eta4ever/rapid-rework/photo/smd.jpg

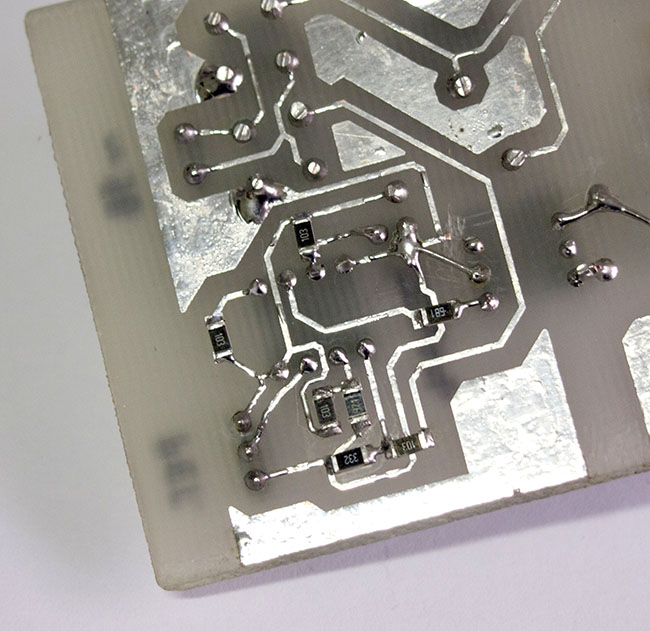
photo/smd.jpg
