eta4ever/rapid-rework/photo/board.jpg

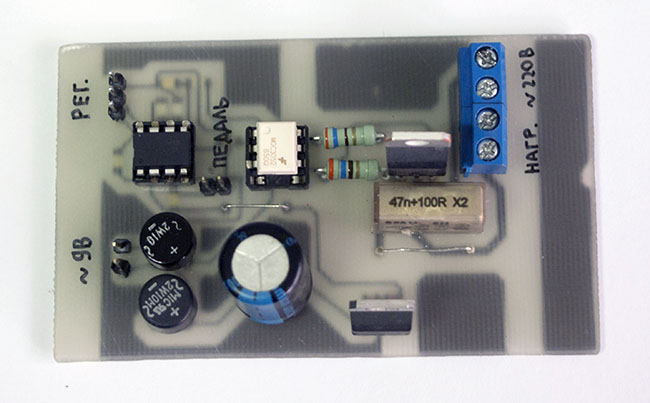
photo/board.jpg
