eta4ever/rapid-rework/README.md

Rapid Rework - electronics replacement for Rapid 106 electric stapler
=========

Замена электроники электрического степлера Rapid 106. Управление на ATtiny13A, MOC3052.
