eta4ever/rapid-rework/(list of files, drawings)

Other design files:
layout.lay6
