eta4ever/rapid-rework/main.sch

## EAGLE design main.sch (2015-04-27)

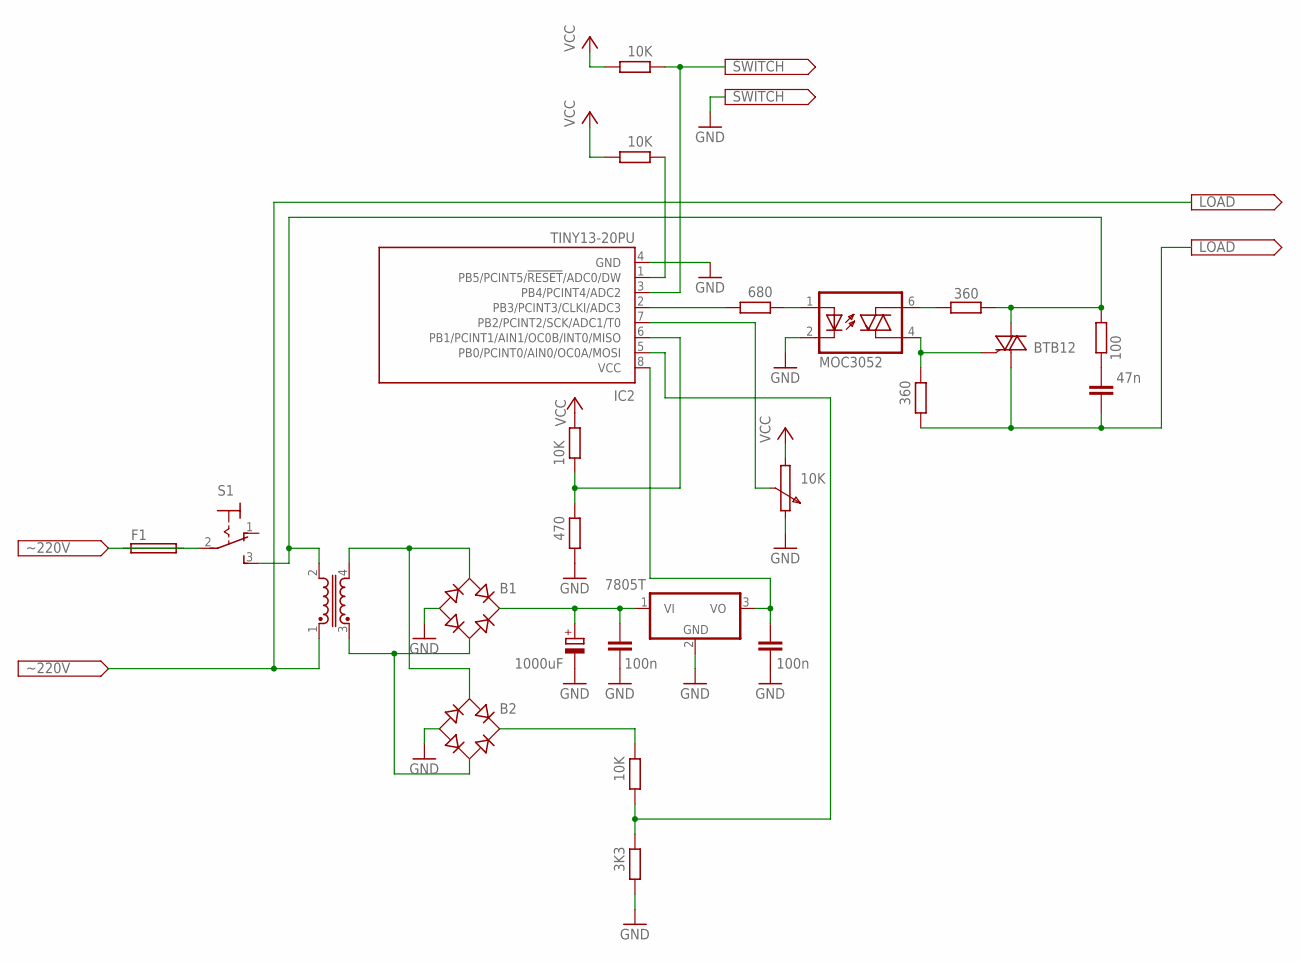
[picture p3: schematic main.sch]

Parts:
B1, B2: MB6S; SOIC-4
F1: FUSEGSH15; GSH15
IC1: 7805T; TO220H
IC2: TINY13-20PU; DIL08
OK1: MOC3052; DIL06
R1: 680; 0204/7
R2, R3: 360; 0204/7
R4: 100; 0204/7
R5, R6, R7, R9: 10K; 0204/7
R8: 3K3; 0204/7
R10: 470; 0204/7
S1: 320-916
T2: BTB12; TO220BV
TR3: U15-TRANSFORMER; U15

Connections:
GND: B1.-, B2.-, IC1.2 (GND), IC2.4 (GND), OK1.2 (C), R8.1, R10.1
unnamed: IC2.2 (PB3/PCINT3/CLKI/ADC3), R1.1
unnamed: OK1.1 (A), R1.2
unnamed: IC2.6 (PB1/PCINT1/AIN1/OC0B/INT0/MISO), R9.1, R10.2
unnamed: B1.~1 (AC1), B2.~1 (AC1), TR3.4
unnamed: B1.~2 (AC2), B2.~2 (AC2), TR3.3
unnamed: B1.+, IC1.1 (VI)
unnamed: IC1.3 (VO), IC2.8 (VCC)
unnamed: B2.+, R7.2
unnamed: F1.1, S1.2
unnamed: R2.2, R4.2, S1.3 (S), T2.T2 (A2), TR3.2
unnamed: IC2.3 (PB4/PCINT4/ADC2), R5.2
unnamed: OK1.6 (A2), R2.1
unnamed: OK1.4 (A1), R3.2, T2.G
unnamed: R3.1, T2.T1 (A1)
unnamed: IC2.5 (PB0/PCINT0/AIN0/OC0A/MOSI), R7.1, R8.2
unnamed: IC2.1 (PB5/PCINT5/!RESET!/ADC0/DW), R6.2
VCC: R5.1, R6.1, R9.2
